baobuibk/SpaceLiinTech_BEE_DAL_PDU_HW_V1.0/01_Design Files/DAL_DPU.PcbDoc.htm

Reporting Options

# File in Previous Format

Date | : | 8/14/2026
Time | : | 4:00:55 PM
Filename | : | D:\Altium_WorkSpace\1_Nanorack_DAL\SpaceLiinTech_BEE_DAL_PDU_HW_V1.0\01_Design Files\DAL_DPU.PcbDoc

Version | Warning
Release 24.4 | CAUTION - This PCB document contains polygon pours with the "Obey Rules" option enabled. If you save the PCB document in this older version, the "Obey Rules" option will be turned off for these polygon pours.

This file was generated by a later version of the software
