baobuibk/SpaceLiinTech_BEE_DAL_PDU_HW_V1.0/01_Design Files/Project Outputs for DAL_PDU/DAL_DPU.xls

Board Stack Report
Stack Up |  | Layer Stack
Layer | Board Layer Stack | Name | Material | Thickness | Constant
1 |  | Top Overlay |  | 0mm
2 |  | Top Solder | Solder Resist | 0.012mm | 3.5
3 |  | L1_TOP |  | 0.04mm
4 |  | Dielectric 2 | PP-022 | 0.2mm | 4.4
5 |  | L2_GND | CF-004 | 0.032mm
6 |  | Dielectric 1 | FR-4 | 1.04mm | 4.5
7 |  | L3_POWER | CF-004 | 0.032mm
8 |  | Dielectric 3 | PP-022 | 0.2mm | 4.4
9 |  | L4_BOT |  | 0.04mm
10 |  | Bottom Solder | Solder Resist | 0.012mm | 3.5
11 |  | Bottom Overlay |  | 0mm
 | Height : 1.608mm
