baobuibk/SpaceLiinTech_BEE_DAL_PDU_HW_V1.0/03_BOM/DAL_PDU_V1.0.xlsx

Name | Designator | Quantity | Footprint | Manufacturer 1 | Manufacturer Part Number 1
22uF | C1, C3, C9, C11, C15, C16, C17, C18, C20, C21, C22, C23, C40, C42, C51, C52, C93, C96, C101, C104, C107 | 21 | CAP_C_2012X110 | KYOCERA AVX | KGM21AR51E226MU
0.1uF | C2, C4, C10, C12, C13, C14, C19, C24, C26, C28, C35, C37, C39, C41, C46, C47, C54, C58, C60, C62, C63, C64, C66, C68, C72, C74, C75, C76, C78, C79, C82, C85, C89, C94, C97, C100, C102, C105, C108 | 39 | CAP_C_1608X80 | Yageo Group | C0603C104K5RACTU
1nF | C5, C6 | 2 | CAP_C_1608X80 | Yageo Group | CC0603KPX7R9BB102
4.7nF | C7, C8, C49 | 3 | CAP_C_1608X80 | Samsung Electro-Mechanics | CL10B472KB8NNNC
10uF | C25, C27, C61, C99 | 4 | CAP_C_2012X110 | TDK | C2012X5R1V106K125AC
DNP/100nF | C29, C30 | 2 | CAP_C_1608X80
1uF | C31, C32, C38, C45, C53, C65, C67, C71, C73, C77, C80, C86, C87, C88 | 14 | CAP_C_1608X80 | TDK | C1608X7R1E105K080AE
DNP/100nF | C33, C34 | 2 | CAP_C_2012X110
4.7uF | C36 | 1 | CAP_C_1608X80 | TDK | C1608X5R1C475K080AC
47uF | C43, C44, C50, C90, C92, C95, C98, C103, C106 | 9 | CAP_C_3225X80 | KYOCERA AVX | KGM32LR51E476MU
100pF | C48 | 1 | CAP_C_1608X80 | Yageo Group | C0603C101K5RACTU
12pF | C55, C56, C57, C59 | 4 | CAP_C_1608X80 | Yageo Group | C0603C120J5GACTU
22pF | C69, C70 | 2 | CAP_C_1608X80 | Yageo Group | C0603C220G5GACTU
0.47uF | C81, C83, C84 | 3 | CAP_C_1608X80 | TAIYO YUDEN | UMK107B7474KA-TR
SS54 | D1, D2 | 2 | DO-214AC_SMA | EVVO | SS54
SMBJ16A | D3, D4, D14 | 3 | DO-214AA_SMB | Littelfuse Inc. | SMBJ16A
DNP/SS54 | D5, D6 | 2 | DO-214AC_SMA
_LED_BLUE | D7, D8, D9, D10, D11, D12, D13 | 7 | LED_0603 | Diodes Inc. | LTST-C191TBKT
ESQ-126-14-G-D | H1, H2 | 2 | ESQ-126-14-G-D | Samtec | ESQ-126-14-G-D
Shield | H3, H4, H5, H6 | 4 | HEX-M3
Header 8x1 | J1 | 1 | Header_254P_8x1
8.2uH | L1, L2 | 2 | INDUCTOR 6363 | Vishay | IHLP2525BDER8R2M01
4.7uH | L3 | 1 | Inductor SMD 6x5.7x5 | Eaton | EXL1V0503-4R7-R
FB 600R | L4 | 1 | L-SMD-0603 | Murata | BLM18KG601SN1D
NT | NT1 | 1 | NETTIE_SMD
UART_CONSOLE | P1 | 1 | 0532610471 | Molex | 53261-0471
532610671 | P4, P7 | 2 | 532610671 | Molex | 53261-0671
AO3400 | Q1 | 1 | SOT-23 | Alpha & Omega Semiconductor Inc. | AO3400
499k | R1, R2 | 2 | RES_C_1608X60 | Yageo Group | RC0603FR-07499KP
16.9k | R3, R5 | 2 | RES_C_1608X60 | Yageo Group | RC0603FR-0716K9L
10k | R4, R6, R11, R26, R31, R48, R53, R56, R58, R60, R63, R65, R67, R68, R69, R71, R76, R77 | 18 | RES_C_1608X60 | Yageo Group | RC0603FR-0710KL
2.21k | R7, R8 | 2 | RES_C_1608X60 | Yageo Group | RC0603FR-072K21L
47.5k | R9, R10 | 2 | RES_C_1608X60 | SEI | RMCF0603FT47K5
100k | R12, R13 | 2 | RES_C_1608X60 | Yageo Group | RC0603FR-07100KL
20k | R14, R15 | 2 | RES_C_1608X60 | Yageo Group | RC0603FR-1320KL
24.9k | R16, R17 | 2 | RES_C_1608X60 | Yageo Group | RC0603FR-0724K9L
DNP/4.7k | R18, R19 | 2 | RES_C_3216X70
20mR | R20 | 1 | RES_C_3216X70 | Bourns | CRF1206FZR020ELF
10R | R21, R24 | 2 | RES_C_1608X60 | Vishay | CRCW060310R0FKEAC
102k | R22 | 1 | RES_C_1608X60 | Yageo Group | RC0603FR-07102KL
332k | R23 | 1 | RES_C_1608X60 | Yageo Group | RC0603FR-07332KL
43k | R25 | 1 | RES_C_1608X60 | Yageo Group | RC0603FR-0743KL
49.9k | R27 | 1 | RES_C_1608X60 | Yageo Group | RC0603FR-0749K9L
DNP/150k | R28 | 1 | RES_C_1608X60
4.7k | R29, R49, R50, R51, R52, R54, R55, R74, R75 | 9 | RES_C_1608X60 | Bourns | CR0603-FX-4701ELF
11.3k | R30 | 1 | RES_C_1608X60 | Bourns | CR0603-FX-1301ELF
1k | R32 | 1 | RES_C_1608X60 | Yageo Group | RC0603FR-071KL
22R | R33, R34, R35, R36, R37, R38, R39, R40, R41, R42, R43, R44, R45, R46, R47, R70, R72, R73, R85, R86, R87, R88 | 22 | RES_C_1608X60 | Yageo Group | RC0603FR-0722RL
120R | R57, R59 | 2 | RES_C_1608X60 | Bourns | CR0603-FX-1200ELF
Shunt 4 Pin | R61, R62, R64, R66 | 4 | RES_C_1206_SHUNT | Susumu | KRL1632E-M-R010-F-T5
1.5k | R78, R80, R82, R83, R84 | 5 | RES_C_1608X60 | Yageo Group | RC0603FR-071K5L
5.1k | R79, R81 | 2 | RES_C_1608X60 | Yageo Group | RC0603FR-075K1L
N/A | SB1, SB2 | 2 | JUMPER_1608
SW2 | SW1 | 1 | SW1-SMD | C&K Components | PTS636SK25FSMTRLFS
TPS259470ARPWR | U1, U2 | 2 | TPS259474 | Texas Instruments | TPS259470ARPWR
LMR33630ADDA | U3, U4 | 2 | HSOIC_8 | Texas Instruments | LMR33630ADDA
TPS55287RYQR | U5 | 1 | VQFN_TPS | Texas Instruments | TPS55287RYQR
ATMEGA128A-AU | U6 | 1 | TQFP-64 | Atmel | ATMEGA128A-AU
MCP2515-SO | U7 | 1 | SOIC-20 | Microchip | MCP2515T-E/SO
SN65HVD251DR | U8 | 1 | SOIC-8 | Texas Instruments | SN65HVD251DR
MAX485ESA+ | U9 | 1 | SOIC127 | Analog Devices | MAX485ESA+
PAC1934T-I/JQ | U10 | 1 | QFN65 | Microchip | PAC1934TI/JQ
TC1047AVNBTR | U11 | 1 | SOT-23 | Microchip | TC1047AVNBTR
SN65C3232PWR | U12 | 1 | TSSOP-16 | Texas Instruments | SN65C3232PWR
TPL5010QDDCTQ1 | U13 | 1 | SOT-23-THN-6 | Texas Instruments | TPL5010QDDCTQ1
24LC04BT-E/SN | U14 | 1 | SOIC_127 | Microchip | 24LC04BT-E/SN
PCA9508DP,118 | U15 | 1 | TSOP8 | NXP Semiconductors | PCA9508DP,118
Crystal 2 Pins | X2 | 1 | CRYSTAL_NX2012SA | KYOCERA AVX | DT2012SB32768H5HPWAA
8Mhz | X3 | 1 | XTAL_3225 | ECS International | ECS-80-8-33Q-ADS
FC5BQCCMC12.0-T1 | XC1 | 1 | AP7-00039 | Abracon | FC5BQCCMC12.0-T1
