baobuibk/SpaceLiinTech_BEE_DAL_PDU_HW_V1.0/08_3D/DAL_DPU.step

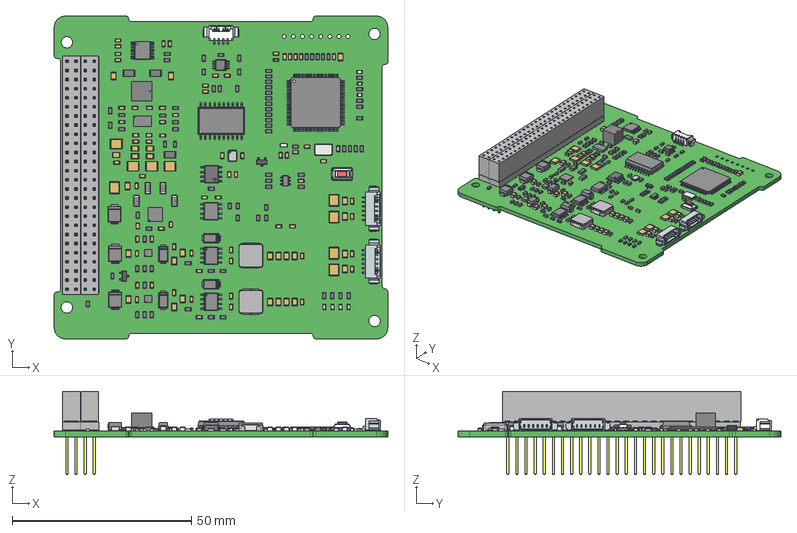
[picture p1: CAD file, 2026-08-21]
08_3D/DAL_DPU.step
93.0 x 90.0 x 23.2 mm
User Library-CRYSTALSMD5X32
Mid Body x 84
Mark x 84
housing x 7
cover x 7
base x 14
Polarity Mark x 7
RES_1206 x 4
SO20
User Library-SOIC-8-1
5BT x 3
ihlp2525bder8r2m01 x 2
SMAJ12A-13-F x 4
User Library-SOT-23-1_1_1 x 2
User Library-SOT-23-1_2_1 x 2
User Library-SOT-23-1_3_1 x 2
User Library-SOT-23-1_4_1 x 2
User Library-SOT-23-1_5_1 x 2
Leader x 8
Extruded x 3
User Library-Button-SMD
ESQ-126-14-G-D_socket x 2
ESQ-126-14-G-D_pins x 2
ESQ-126-14-G-D2_pins x 2
ESQ-126-14-G-D-LL_bpins x 2
IND_XGL5050_COC
Y3225
Pin1
Pin2
CeramicBody
