baobuibk/SpaceLiinTech_BEE_DAL_PDU_HW_V1.0/05_SMT/DAL_DPU_V1.0.pdf

A

B

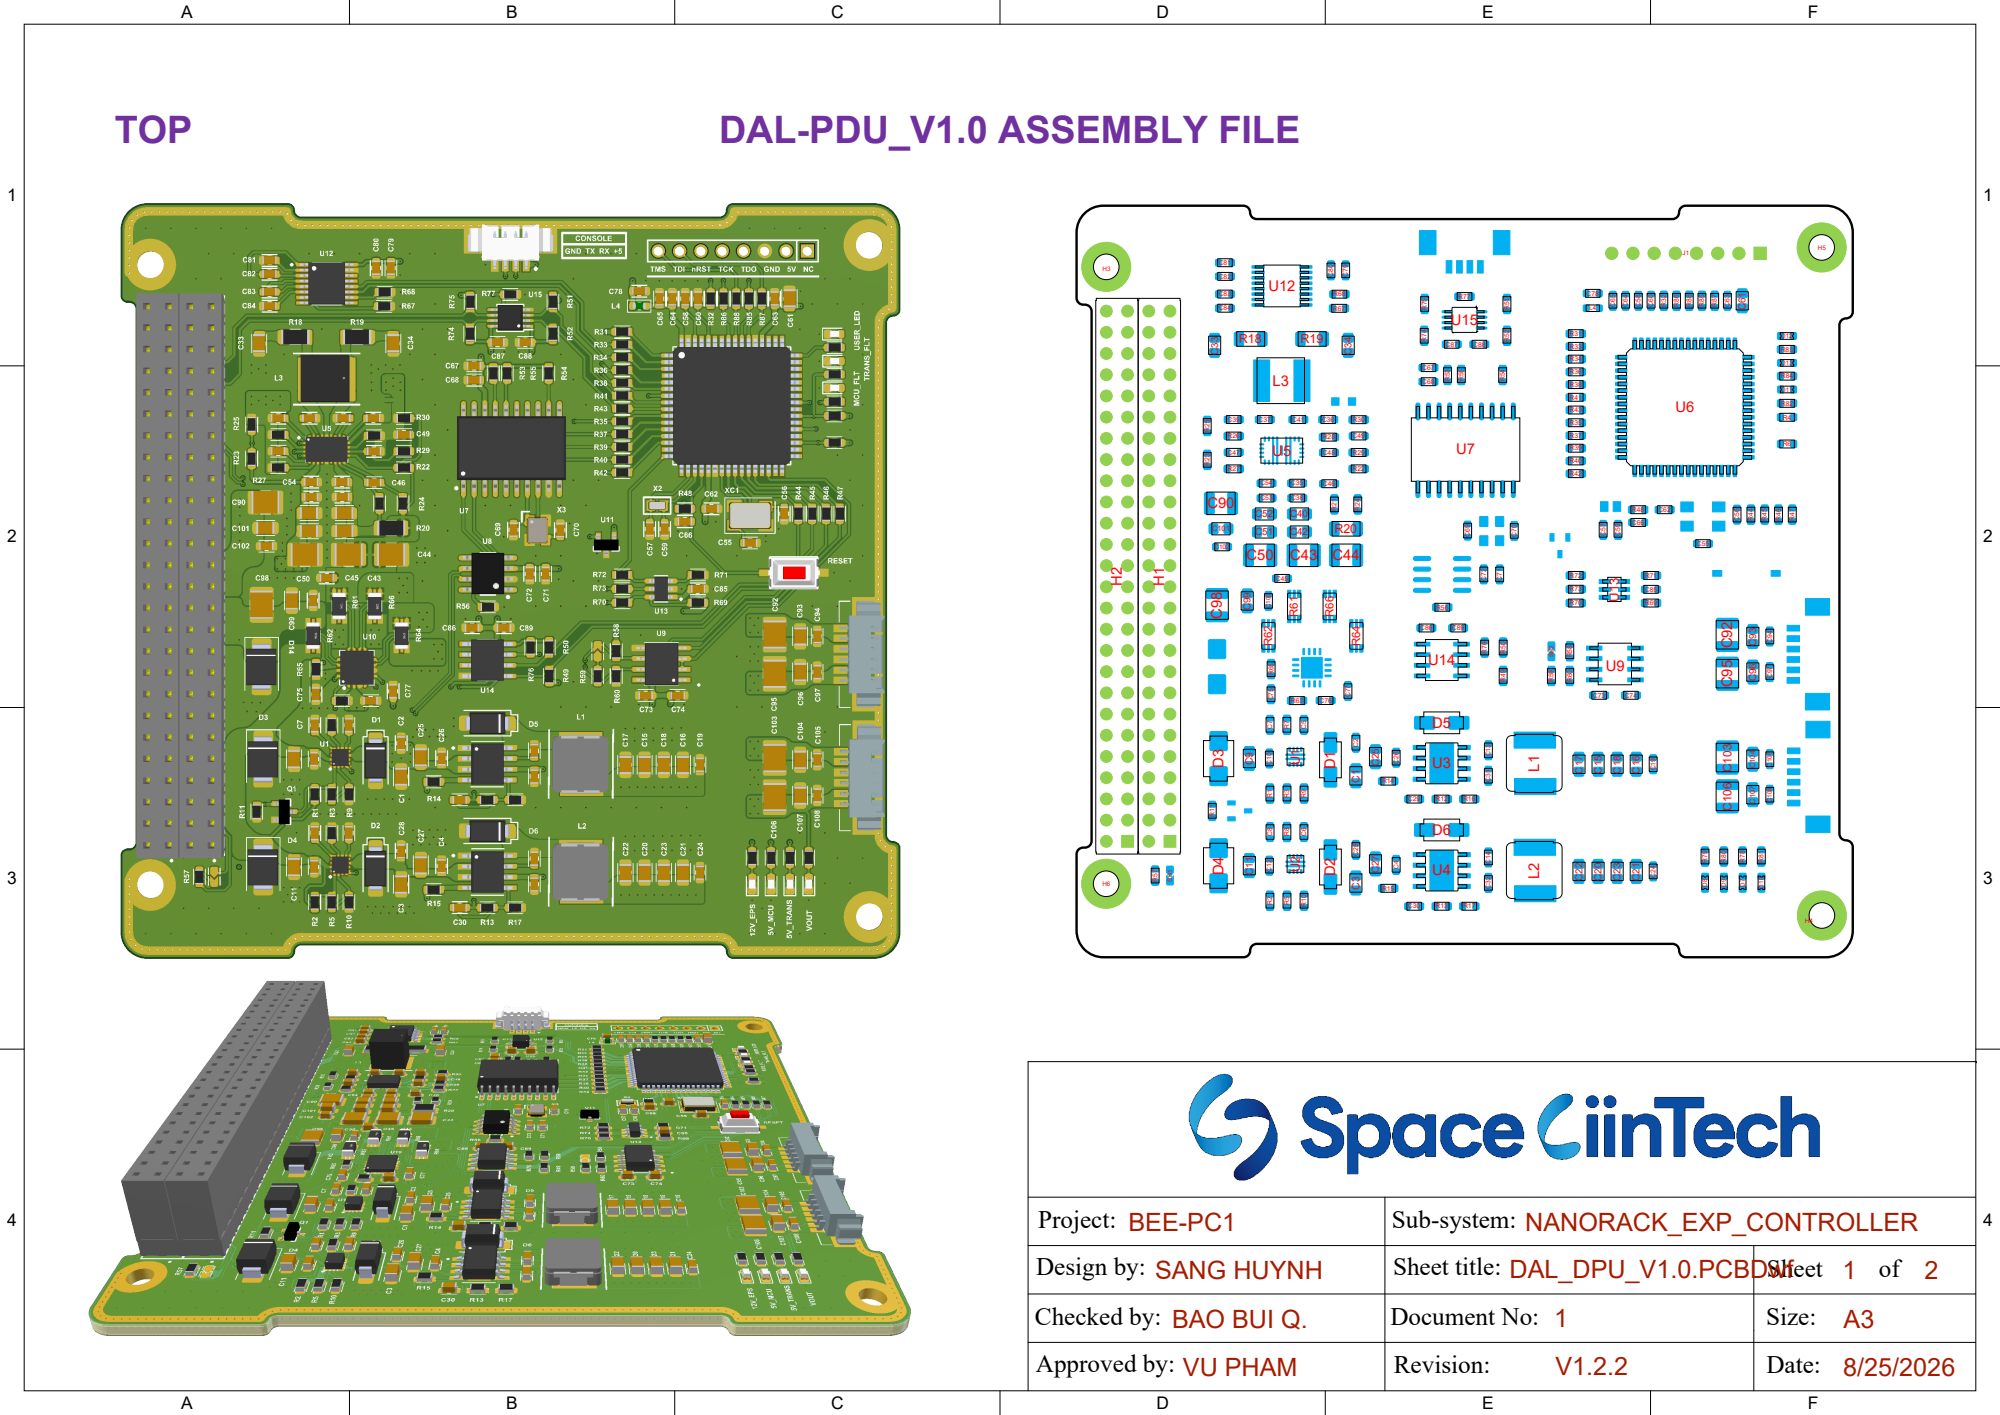
[picture p17: page 1]

A

B

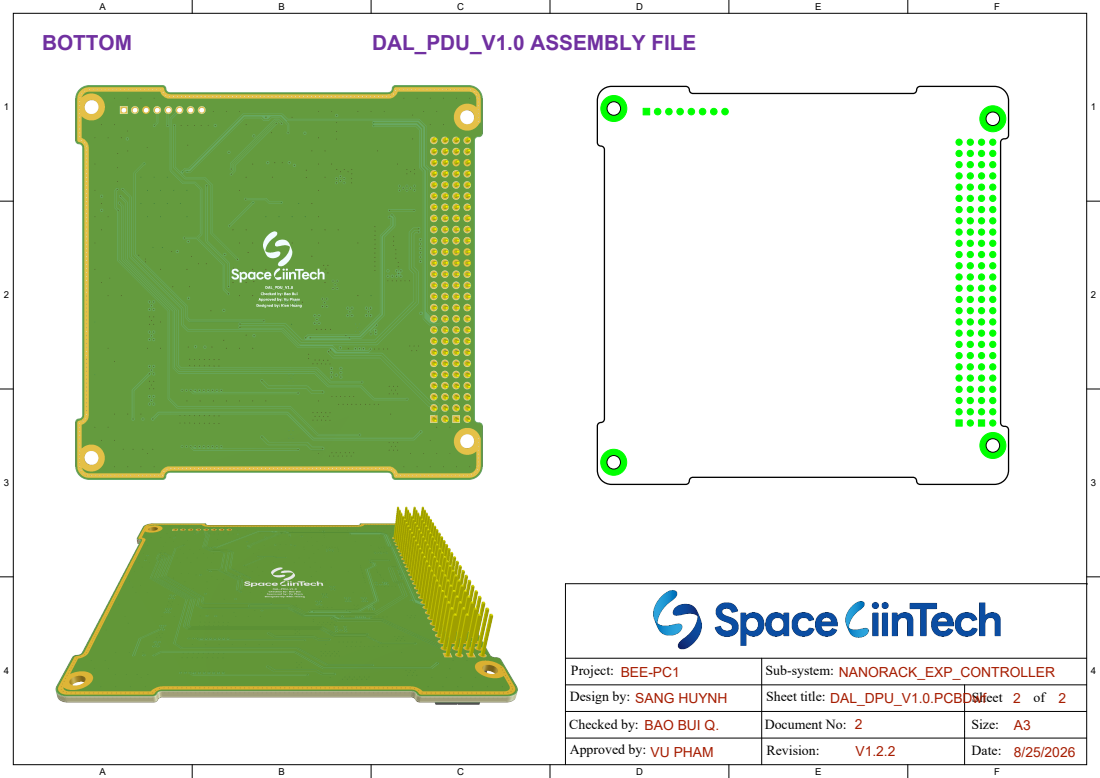
[picture p18: page 2]
Sheet title:; Project:; Revision:; Document No:; Size:; Sheet; Date: 8/25/2026; SANG HUYNH; Sub-system:; Checked by:; Approved by:; Design by:; BAO BUI Q.; VU PHAM; BEE-PC1; DAL_DPU_V1.0.PCBDwf; NANORACK_EXP_CONTROLLER; BOTTOM; DAL_PDU_V1.0 ASSEMBLY FILE
