baobuibk/SpaceLiinTech_BEE_DAL_PDU_HW_V1.0/(list of files, drawings)

Other design files:
01_Design Files/Buck 5-12V.SchDoc
01_Design Files/Buck 5V.SchDoc
01_Design Files/CAN.SchDoc
01_Design Files/Connectors.SchDoc
01_Design Files/CoverPage.SchDoc
01_Design Files/DAL_DPU.PcbDoc
01_Design Files/DAL_PDU.PrjPcb
01_Design Files/eFuse.SchDoc
01_Design Files/I2C.SchDoc
01_Design Files/LABLIB.PcbLib
01_Design Files/LABLIB.SchLib
01_Design Files/LED.SchDoc
01_Design Files/MAX232.SchDoc
01_Design Files/MCU.SchDoc
01_Design Files/Mounting Holes.SchDoc
01_Design Files/PowerMonitor.SchDoc
01_Design Files/RS232.SchDoc
01_Design Files/RS485.SchDoc
01_Design Files/TemperatureSensor.SchDoc
01_Design Files/TEST POITN.SchDoc
01_Design Files/WatchDog.SchDoc
