baobuibk/SpaceLiinTech_BEE_DAL_PDU_HW_V1.0/(commit log)

2026-07-09 Initial Hardware Project
    [ATMEGA128A-AU.SchLib, Buck 5V.SchDoc, Buck-Boost 5-12V.SchDoc, CAN.SchDoc, Connectors.SchDoc, CoverPage.SchDoc, DAL_DPU.PcbDoc, DAL_PDU.PrjPcb]
2026-07-10 Update 10/7/2026
    [ATMEGA128A-AU.SchLib, Buck-Boost 5-12V.SchDoc, CAN.SchDoc, Connectors.SchDoc, DAL_PDU.PrjPcb, LED.SchDoc, MAX232.SchDoc, MCU.SchDoc]
2026-07-10 Update Schematic PDF
2026-07-10 Update Structure
    [ATMEGA128A-AU.SchLib, QFP80P1600X1600X120-64N.PcbLib]
2026-07-13 Update 12/7_1
    [Connectors.SchDoc, eFuse.SchDoc]
2026-07-13 Update 13/7_2
    Update Ref
    [ATMEGA128A-AU.SchLib, QFP80P1600X1600X120-64N.PcbLib]
2026-07-13 Update 13/7 _2
    update Mapping GPIO excel
    [ATMEGA128A-AU.SchLib, DAL_PDU_GPIO_Mapping.xlsx, MCU.SchDoc, QFP80P1600X1600X120-64N.PcbLib]
2026-07-15 update Lab Lib
    [Buck 5-12V.SchDoc, Buck 5V.SchDoc, CAN.SchDoc, Connectors.SchDoc, DAL_PDU.PrjPcb, LABLIB.PcbLib, LABLIB.SchLib, LED.SchDoc]
2026-07-16 Update PCB
    Update full components Power in top layer ,Stunt will be in top layer and power layer can be taken by header
    [Buck 5-12V.SchDoc, Buck 5V.SchDoc, CAN.SchDoc, Connectors.SchDoc, DAL_DPU.PcbDoc, DAL_PDU.PrjPcb, LED.SchDoc, MAX232.SchDoc]
2026-07-16 Update PCB
    [CAN.SchDoc, DAL_DPU.PcbDoc, DAL_PDU.PrjPcb, LED.SchDoc, MAX232.SchDoc, MCU.SchDoc, RS485.SchDoc, WatchDog.SchDoc]
2026-07-17 Update PCB 17_7 -1
    [Buck 5V.SchDoc, CAN.SchDoc, Connectors.SchDoc, DAL_DPU.PcbDoc, DAL_PDU.PrjPcb, LED.SchDoc, MAX232.SchDoc, MCU.SchDoc]
2026-07-19 Update PCB design 85%
    [Connectors.SchDoc, DAL_DPU.PcbDoc, MCU.SchDoc, RS485.SchDoc]
2026-07-21 Update PCB completed 95%
    [Buck 5-12V.SchDoc, CAN.SchDoc, Connectors.SchDoc, DAL_DPU.PcbDoc, DAL_PDU.PrjPcb, I2C.SchDoc, LED.SchDoc, MAX232.SchDoc]
2026-07-22 ADD TOP OVERPLAY PCB
    [DAL_DPU.PcbDoc, MCU.SchDoc]
2026-07-23 UPDATE SCHEMATIC
    [Buck 5-12V.SchDoc, Buck 5V.SchDoc, CAN.SchDoc, Connectors.SchDoc, DAL_DPU.PcbDoc, DAL_PDU.PrjPcb, I2C.SchDoc, LED.SchDoc]
2026-08-11 Update full BOM
    [Buck 5-12V.SchDoc, Connectors.SchDoc, DAL_DPU.PcbDoc, DAL_DPU.step, DAL_DPU.xls, DAL_PDU.PrjPcb, DAL_PDU.xlsx, DAL_PDU_BOM_Descriptions(2).xlsx]
2026-08-11 Update Full Prj
    Fix all BOM
    update Structure
    [ATMEGA128A-AU.SchLib, DAL_DPU.step, DAL_PDU_BOM_Descriptions(2).xlsx, DAL_PDU_BOM_Descriptions.xlsx, DAL_PDU_GPIO_Mapping.xlsx, QFP80P1600X1600X120-64N.PcbLib, SOP65P640X120-16N.PcbLib, ihlp2525bder8r2m01.stp]
2026-08-11 Upate Full and Fix Full
    [Buck 5-12V.SchDoc, DAL_DPU.PcbDoc, DAL_PDU.PrjPcb, DAL_PDU.xlsx, I2C.SchDoc]
2026-08-12 Fix all Issue
    -Fix Schematic
    -Fix BOM
    -Update PCB
    -Check DRC
    [DAL_DPU.PcbDoc, DAL_DPU.step, DAL_PDU.PrjPcb, DAL_PDU.xlsx, DAL_PDU_V1.0.xlsx, RS232.SchDoc]
2026-08-18 layout done
    [Buck 5-12V.SchDoc, CAN.SchDoc, Connectors.SchDoc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]
2026-08-18 gerber release
    [DAL_DPU.PcbDoc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]
2026-08-19 update gerber
    [Connectors.SchDoc, DAL_DPU.PcbDoc, DAL_DPU.step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]
2026-08-20 update BOM
    [Buck 5-12V.SchDoc, DAL_DPU.PcbDoc, DAL_PDU_V1.0.xlsx, eFuse.SchDoc]
2026-08-21 update 3d
    [DAL_DPU.step]
2026-08-25 add smt file
    [DAL_DPU.PcbDoc, DAL_DPU.xls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]
2026-09-15 export gerber pcb_v1.1
    [Buck 5-12V.SchDoc, Buck 5V.SchDoc, CAN.SchDoc, Connectors.SchDoc, CoverPage.SchDoc, DAL_DPU.PcbDoc, DAL_DPU.xls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]
